AronASzucs/Avalanche32/Images/3D/iso_back_left.png

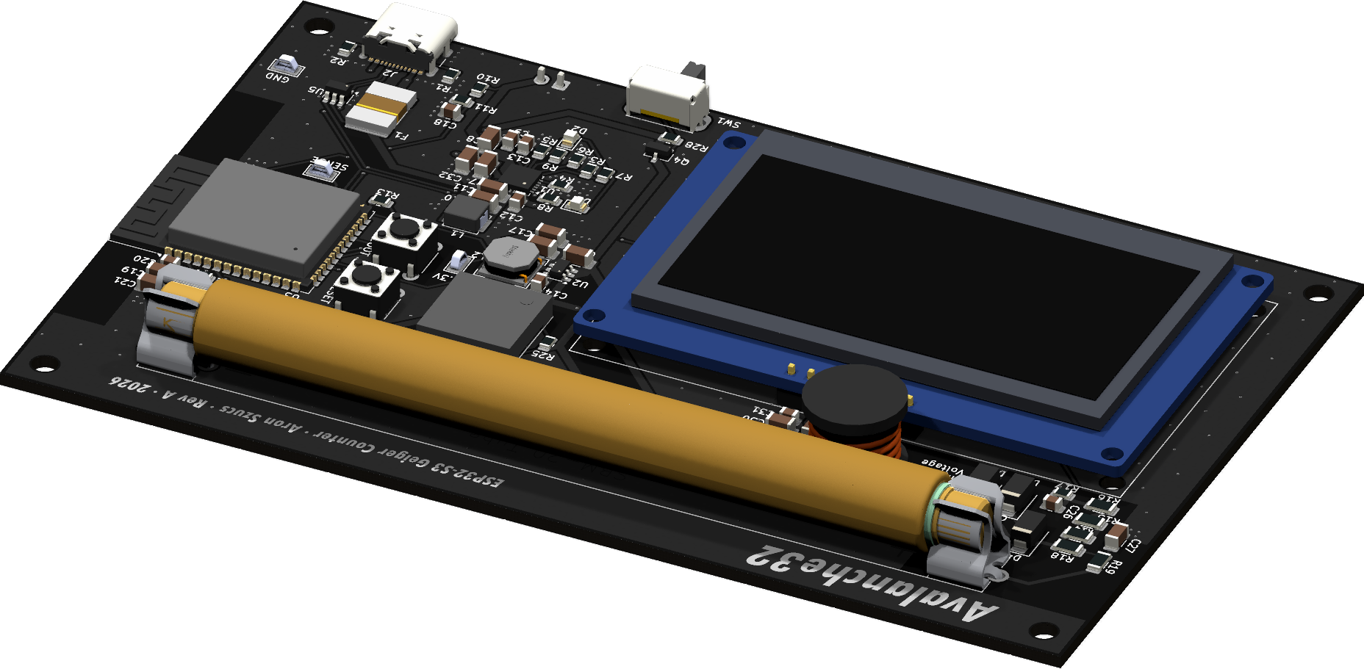
Images/3D/iso_back_left.png
