AronASzucs/Avalanche32/Images/3D/iso_back_right.png

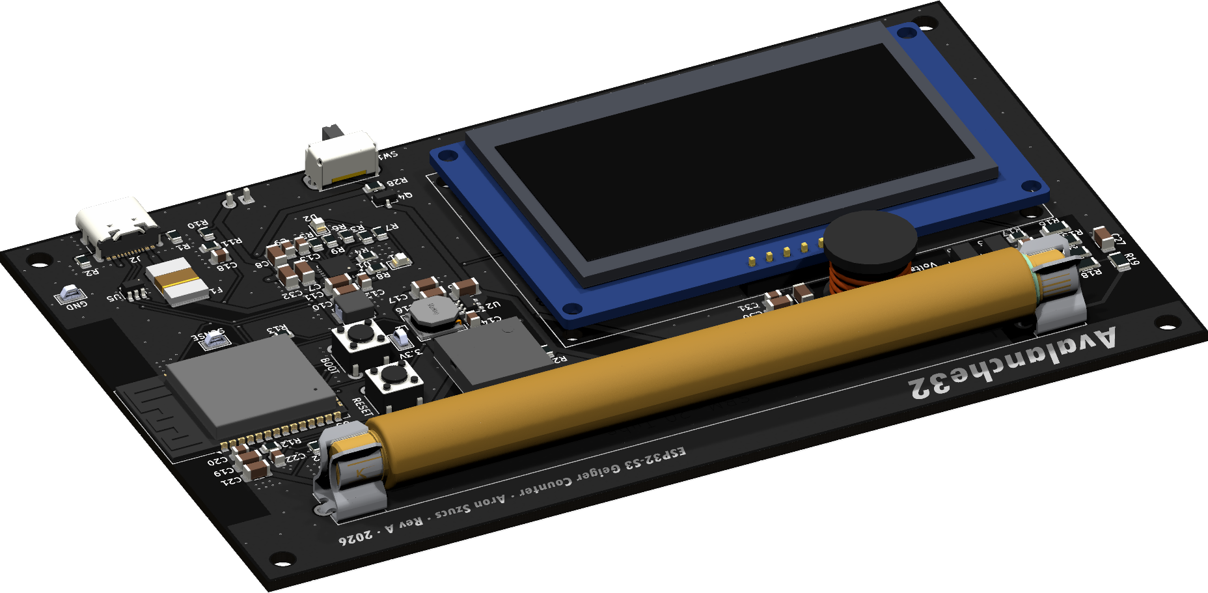
Images/3D/iso_back_right.png
