AronASzucs/Avalanche32/Images/3D/iso_bottom_back.png

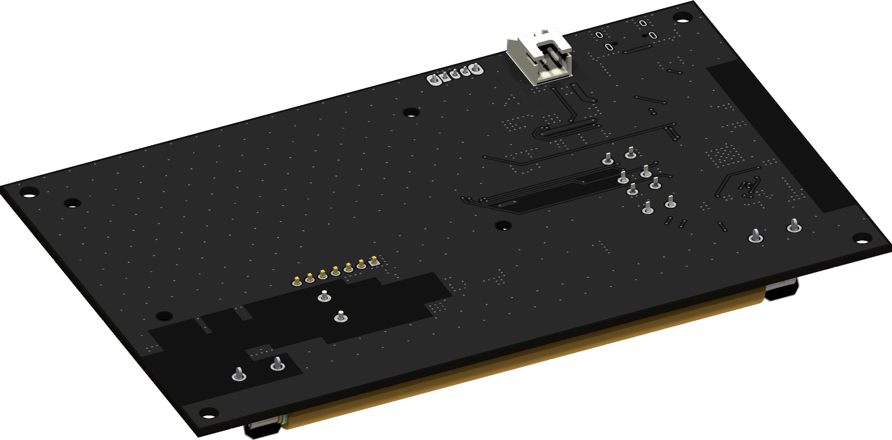
Images/3D/iso_bottom_back.png
