AronASzucs/Avalanche32/Images/3D/iso_bottom_front.png

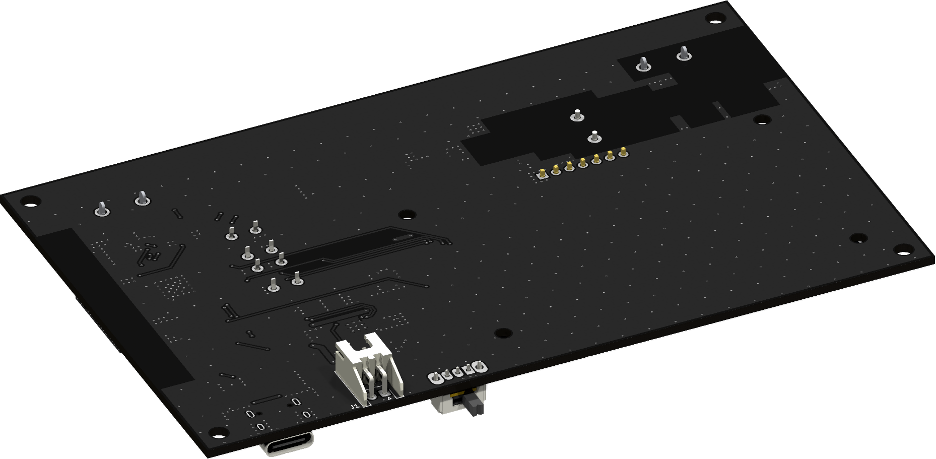
Images/3D/iso_bottom_front.png
