AronASzucs/Avalanche32/Images/3D/iso_front_right.png

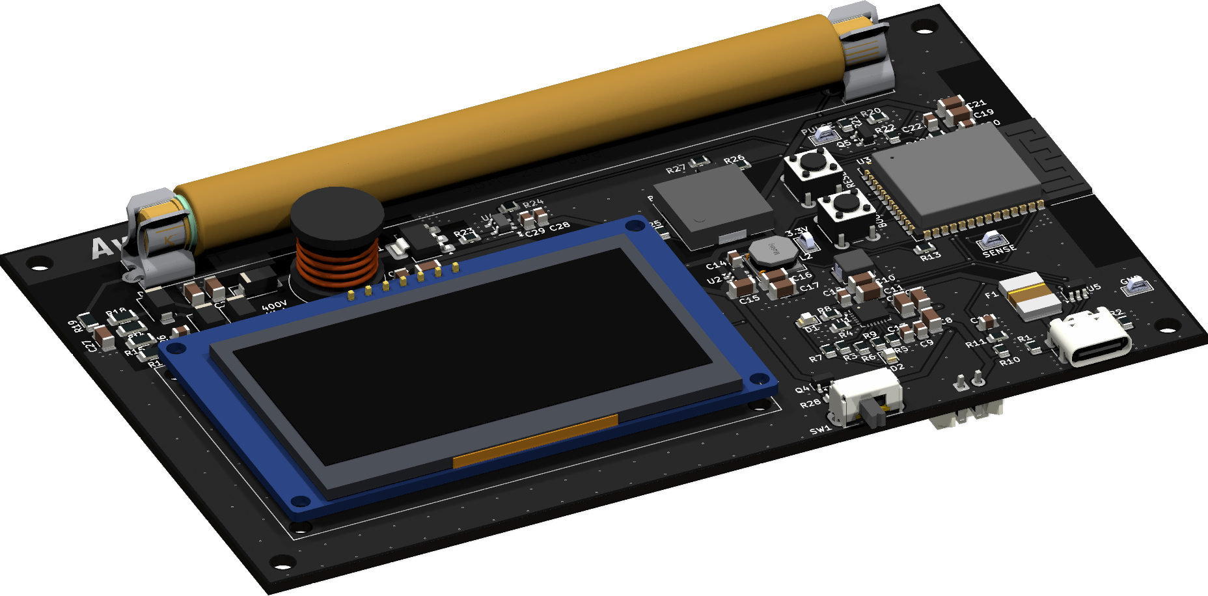
Images/3D/iso_front_right.png
