AronASzucs/Avalanche32/Images/3D/side_back.png

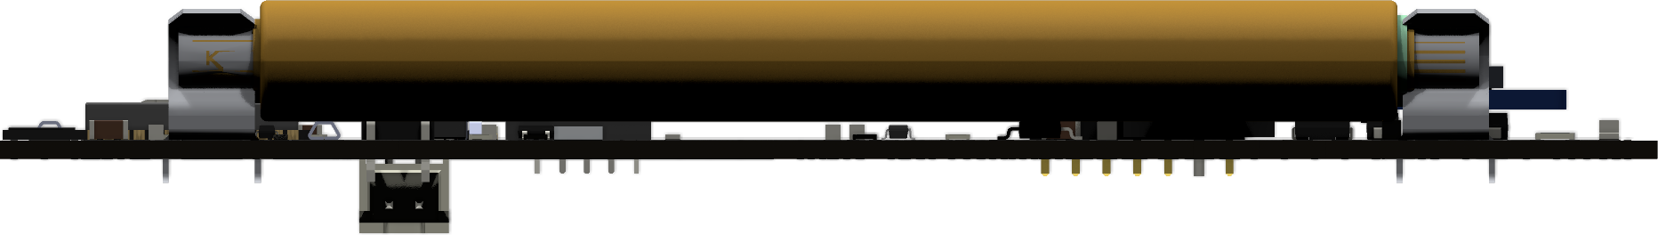
Images/3D/side_back.png
