AronASzucs/Avalanche32/Images/3D/side_front.png

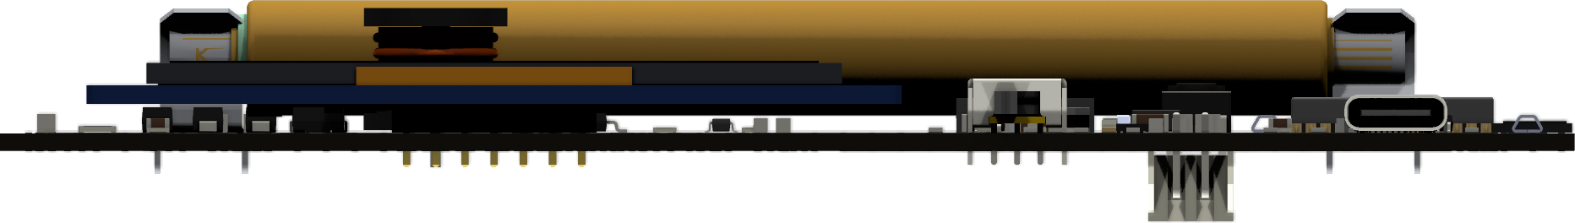
Images/3D/side_front.png
