AronASzucs/Avalanche32/Images/3D/side_left.png

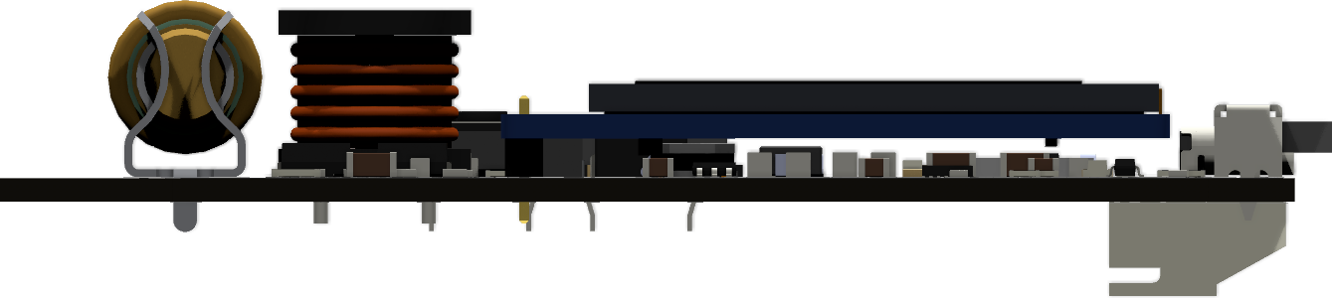
Images/3D/side_left.png
