AronASzucs/Avalanche32/Images/3D/side_right.png

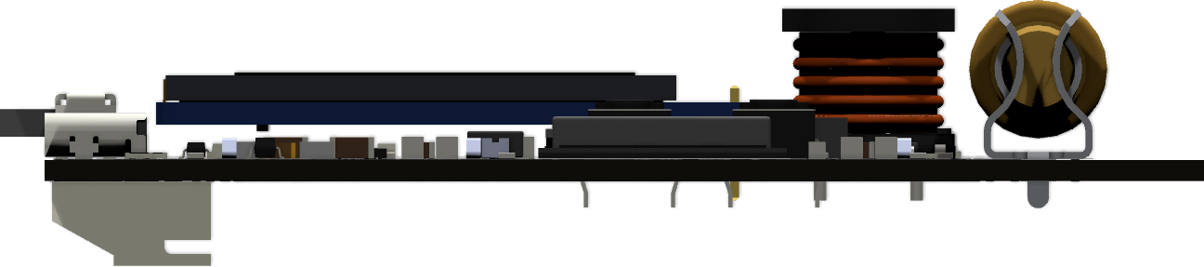
Images/3D/side_right.png
