AronASzucs/Avalanche32/Images/Layers/B_Courtyard.png

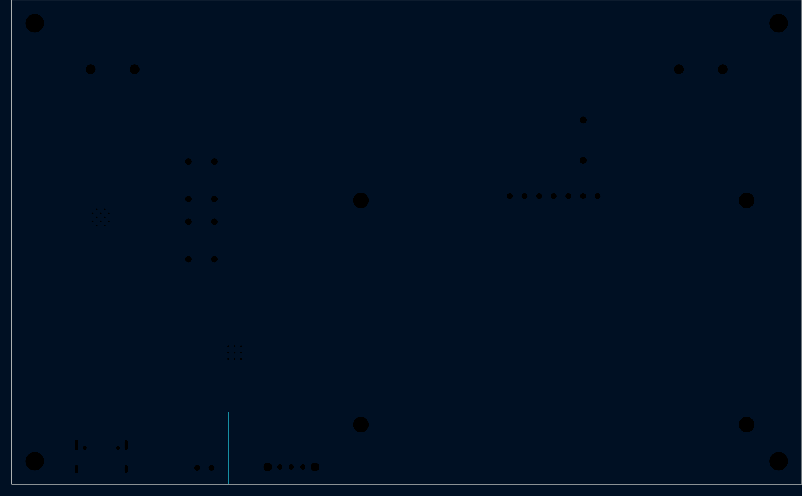
Images/Layers/B_Courtyard.png
