AronASzucs/Avalanche32/Images/Layers/B_Cu.png

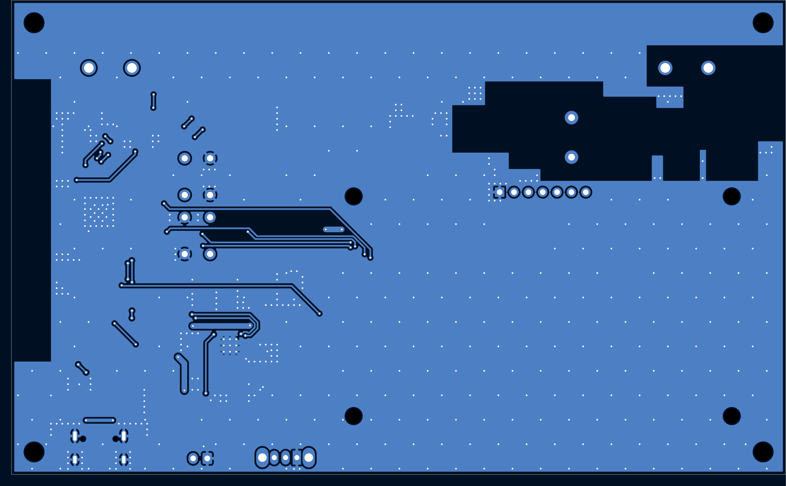
Images/Layers/B_Cu.png
