AronASzucs/Avalanche32/Images/Layers/B_Fab.png

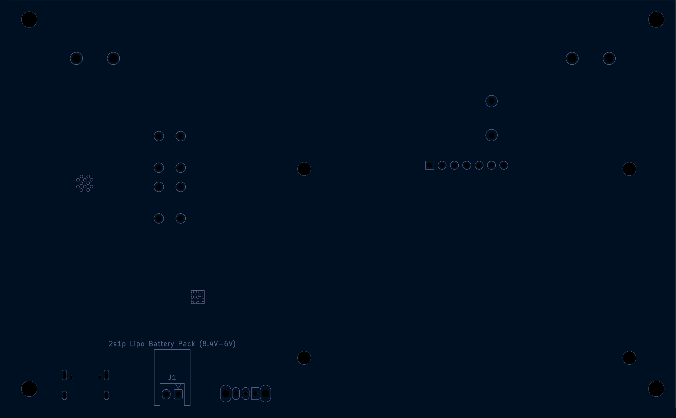
Images/Layers/B_Fab.png
