AronASzucs/Avalanche32/Images/Layers/B_Mask.png

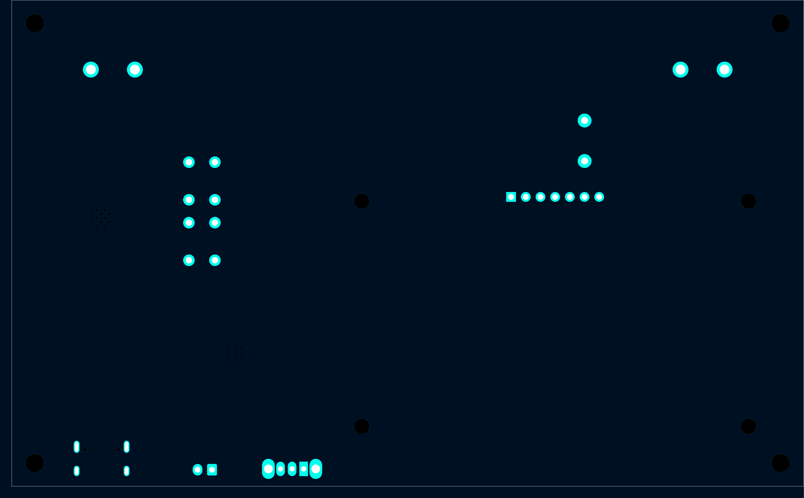
Images/Layers/B_Mask.png
