AronASzucs/Avalanche32/Images/Layers/copper_both.png

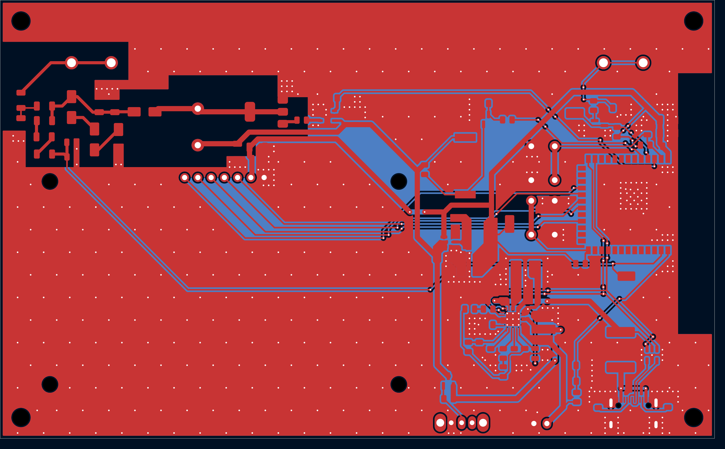
Images/Layers/copper_both.png
