AronASzucs/Avalanche32/Images/Layers/drill_map.png

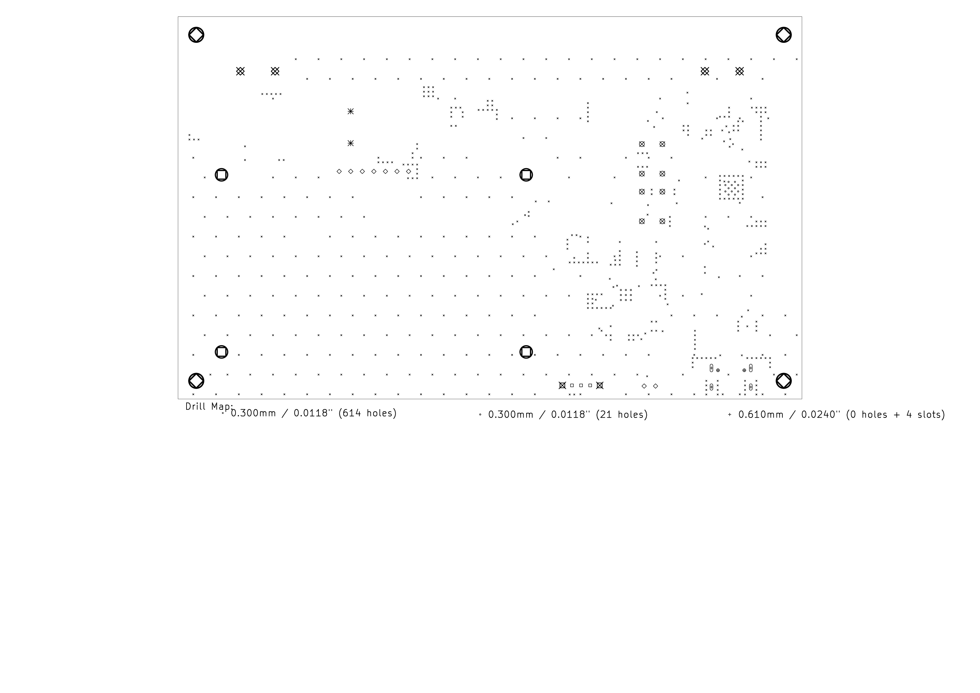
Images/Layers/drill_map.png
