AronASzucs/Avalanche32/Images/Layers/Edge_Cuts.png

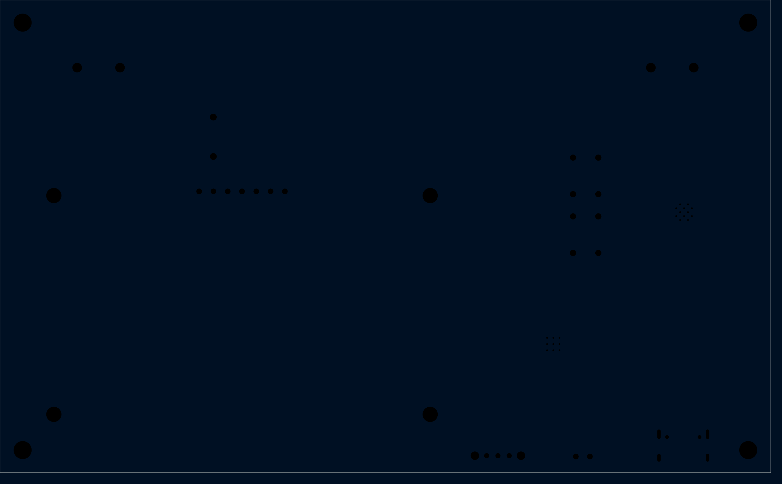
Images/Layers/Edge_Cuts.png
