AronASzucs/Avalanche32/Images/Layers/F_Courtyard.png

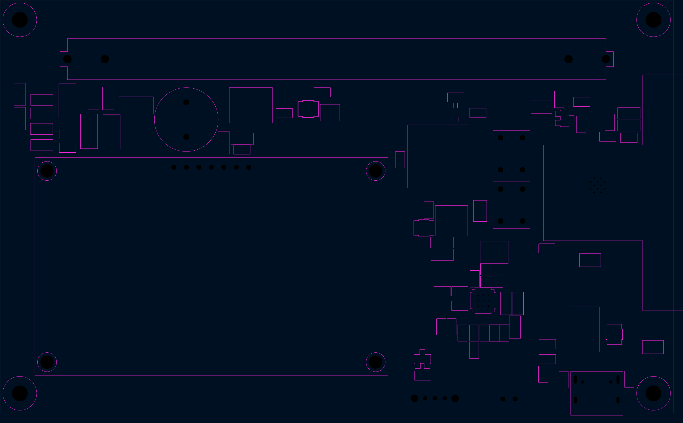
Images/Layers/F_Courtyard.png
