AronASzucs/Avalanche32/Images/Layers/F_Cu.png

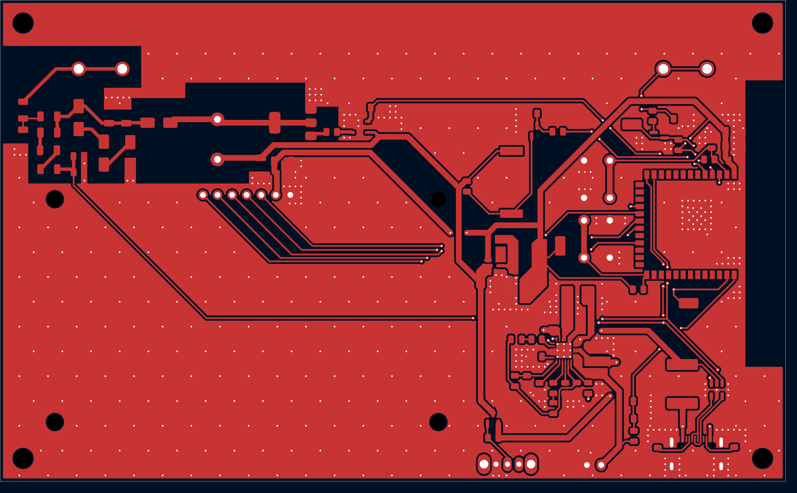
Images/Layers/F_Cu.png
