AronASzucs/Avalanche32/Images/Layers/F_Fab.png

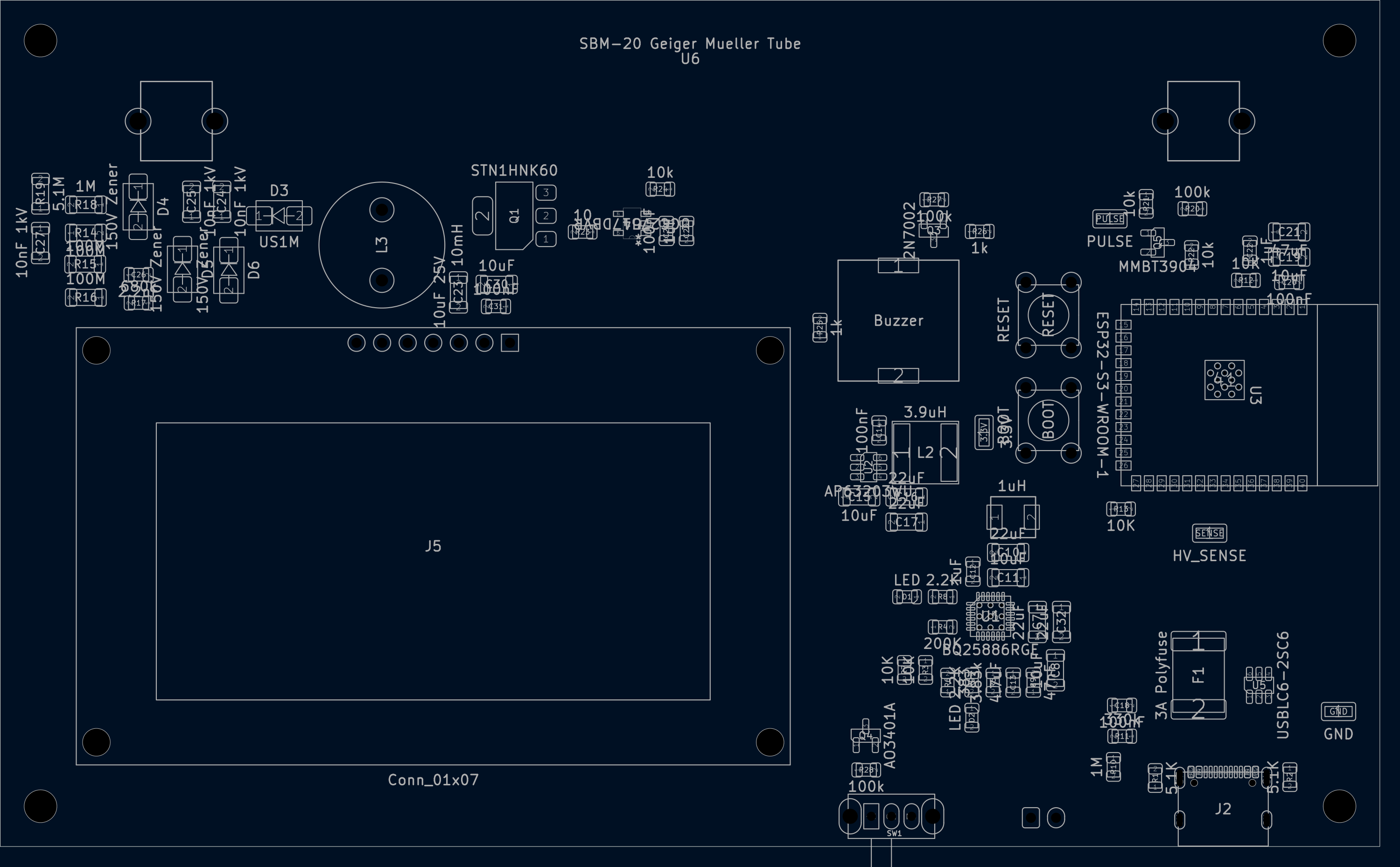
Images/Layers/F_Fab.png
