AronASzucs/Avalanche32/Images/Layers/F_Mask.png

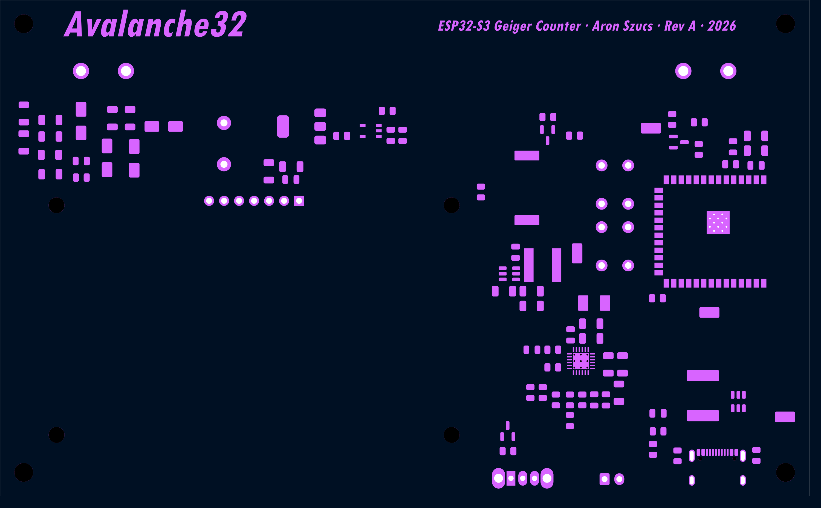
Images/Layers/F_Mask.png
