AronASzucs/Avalanche32/Images/Layers/F_Paste.png

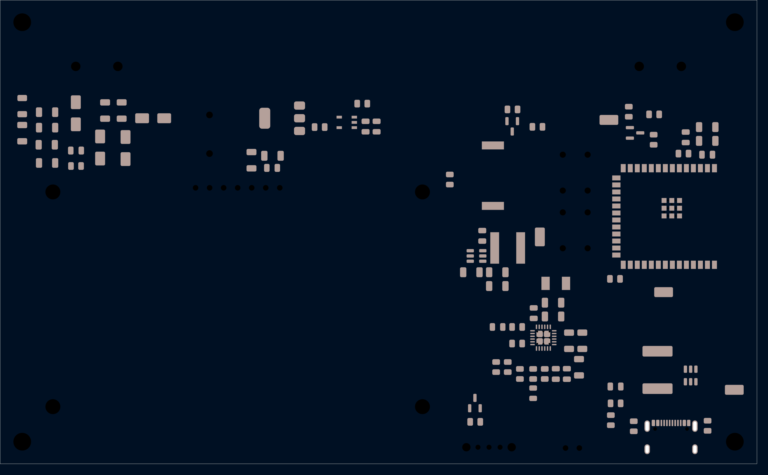
Images/Layers/F_Paste.png
