AronASzucs/Avalanche32/Images/Layers/F_Silkscreen.png

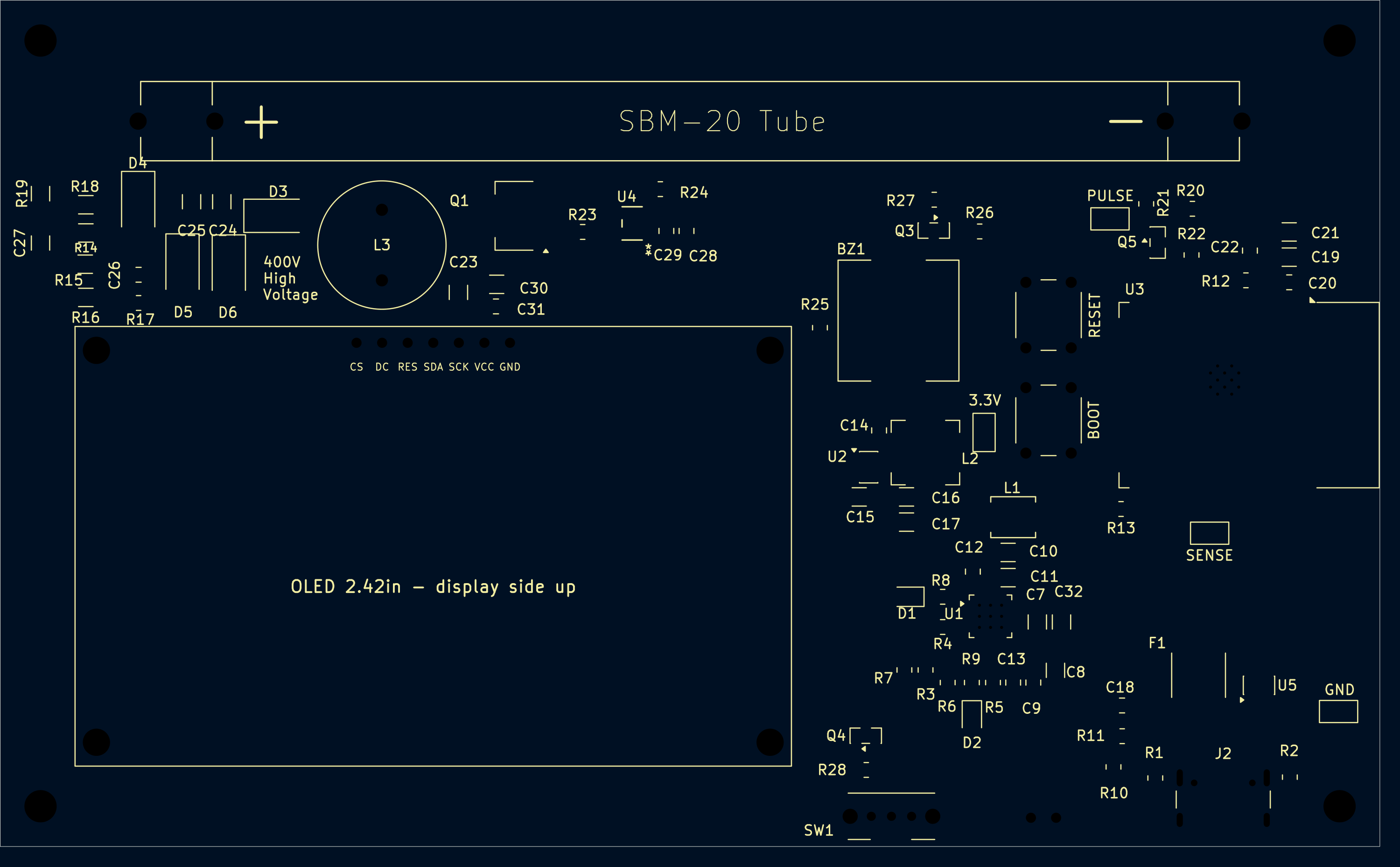
Images/Layers/F_Silkscreen.png
