AronASzucs/Avalanche32/production/bom.csv

Designator | Footprint | Quantity | Value | LCSC Part #
3.3V | TestPoint_Keystone_5015_Micro_Mini | 1 | 3.3V
BOOT | SW_PUSH_6mm | 1 | BOOT
BZ1 | XDCR_CPT-1203-78-SMT-TR | 1 | Buzzer
C10, C16, C17, C32, C7 | 1206 | 5 | 22uF
C11, C15, C19, C30, C8 | 1206 | 5 | 10uF
C12, C22, C28 | 0805 | 3 | 1uF
C13 | 0805 | 1 | 4.7uF
C14, C18, C20, C29, C31 | 0805 | 5 | 100nF
C21 | 1206 | 1 | 47uF
C23 | 1206 | 1 | 10uF 25V
C24, C25, C27 | 1206 | 3 | 10nF 1kV
C26 | 0805 | 1 | 2.2nF
C9 | 0805 | 1 | 47nF
D1, D2 | 0805 | 2 | LED
D3 | D_SMA | 1 | US1M
D4, D5, D6 | D_SMA | 3 | 150V Zener
F1 | 2920 | 1 | 3A Polyfuse
GND | TestPoint_Keystone_5015_Micro_Mini | 1 | GND
J1 | JST_XH_S2B-XH-A_1x02_P2.50mm_Horizontal | 1 | 2s1p Lipo Battery Pack (8.4V-6V)
J2 | USB_C_Receptacle_GCT_USB4105-xx-A_16P_TopMnt_Horizontal | 1 | USB_C_Receptacle_USB2.0_16P
J5 | OLED_2.42in_SSD1309_SPI_7pin | 1 | Conn_01x07
L1 | IND_SRP4020TA-1R0M | 1 | 1uH
L2 | L_Bourns-SRN6028 | 1 | 3.9uH
L3 | L_Radial_D12.5mm_P7.00mm_Fastron_09HCP | 1 | 10mH
PULSE | TestPoint_Keystone_5015_Micro_Mini | 1 | PULSE
Q1 | SOT-223-3_TabPin2 | 1 | STN1HNK60
Q3 | SOT-23 | 1 | 2N7002
Q4 | SOT-23 | 1 | AO3401A
Q5 | SOT-23 | 1 | MMBT3904
R1, R2 | 0805 | 2 | 5.1K
R10 | 0805 | 1 | 1M
R11 | 0805 | 1 | 330k
R12, R13, R21, R22, R24, R3, R7 | 0805 | 7 | 10K
R14, R15, R16 | 1206 | 3 | 100M
R17 | 0805 | 1 | 680k
R18 | 1206 | 1 | 1M
R19 | 1206 | 1 | 5.1M
R20, R27, R28 | 0805 | 3 | 100k
R23 | 0805 | 1 | 10
R25, R26 | 0805 | 2 | 1k
R4 | 0805 | 1 | 200K
R5 | 0805 | 1 | 3.83k
R6 | 0805 | 1 | 383
R8, R9 | 0805 | 2 | 2.2K
RESET | SW_PUSH_6mm | 1 | RESET
SENSE | TestPoint_Keystone_5015_Micro_Mini | 1 | HV_SENSE
SW1 | SW_Slide_SPDT_Angled_CK_OS102011MA1Q | 1 | SW_SPDT
U1 | Texas_RGE0024H_VQFN-24-1EP_4x4mm_P0.5mm_EP2.7x2.7mm_ThermalVias | 1 | BQ25886RGE
U2 | TSOT-23-6 | 1 | AP63203WU
U3 | ESP32-S3-WROOM-1 | 1 | ESP32-S3-WROOM-1
U4 | DBV5_TEX | 1 | UCC27517DBVR
U5 | SOT-23-6 | 1 | USBLC6-2SC6
U6 | SBM-20 Tube | 1 | SBM-20 Geiger Mueller Tube
