AronASzucs/Avalanche32/ESP32-Geiger-Counter.kicad_pcb

## KiCad design ESP32-Geiger-Counter.kicad_pcb (2026-10-28)

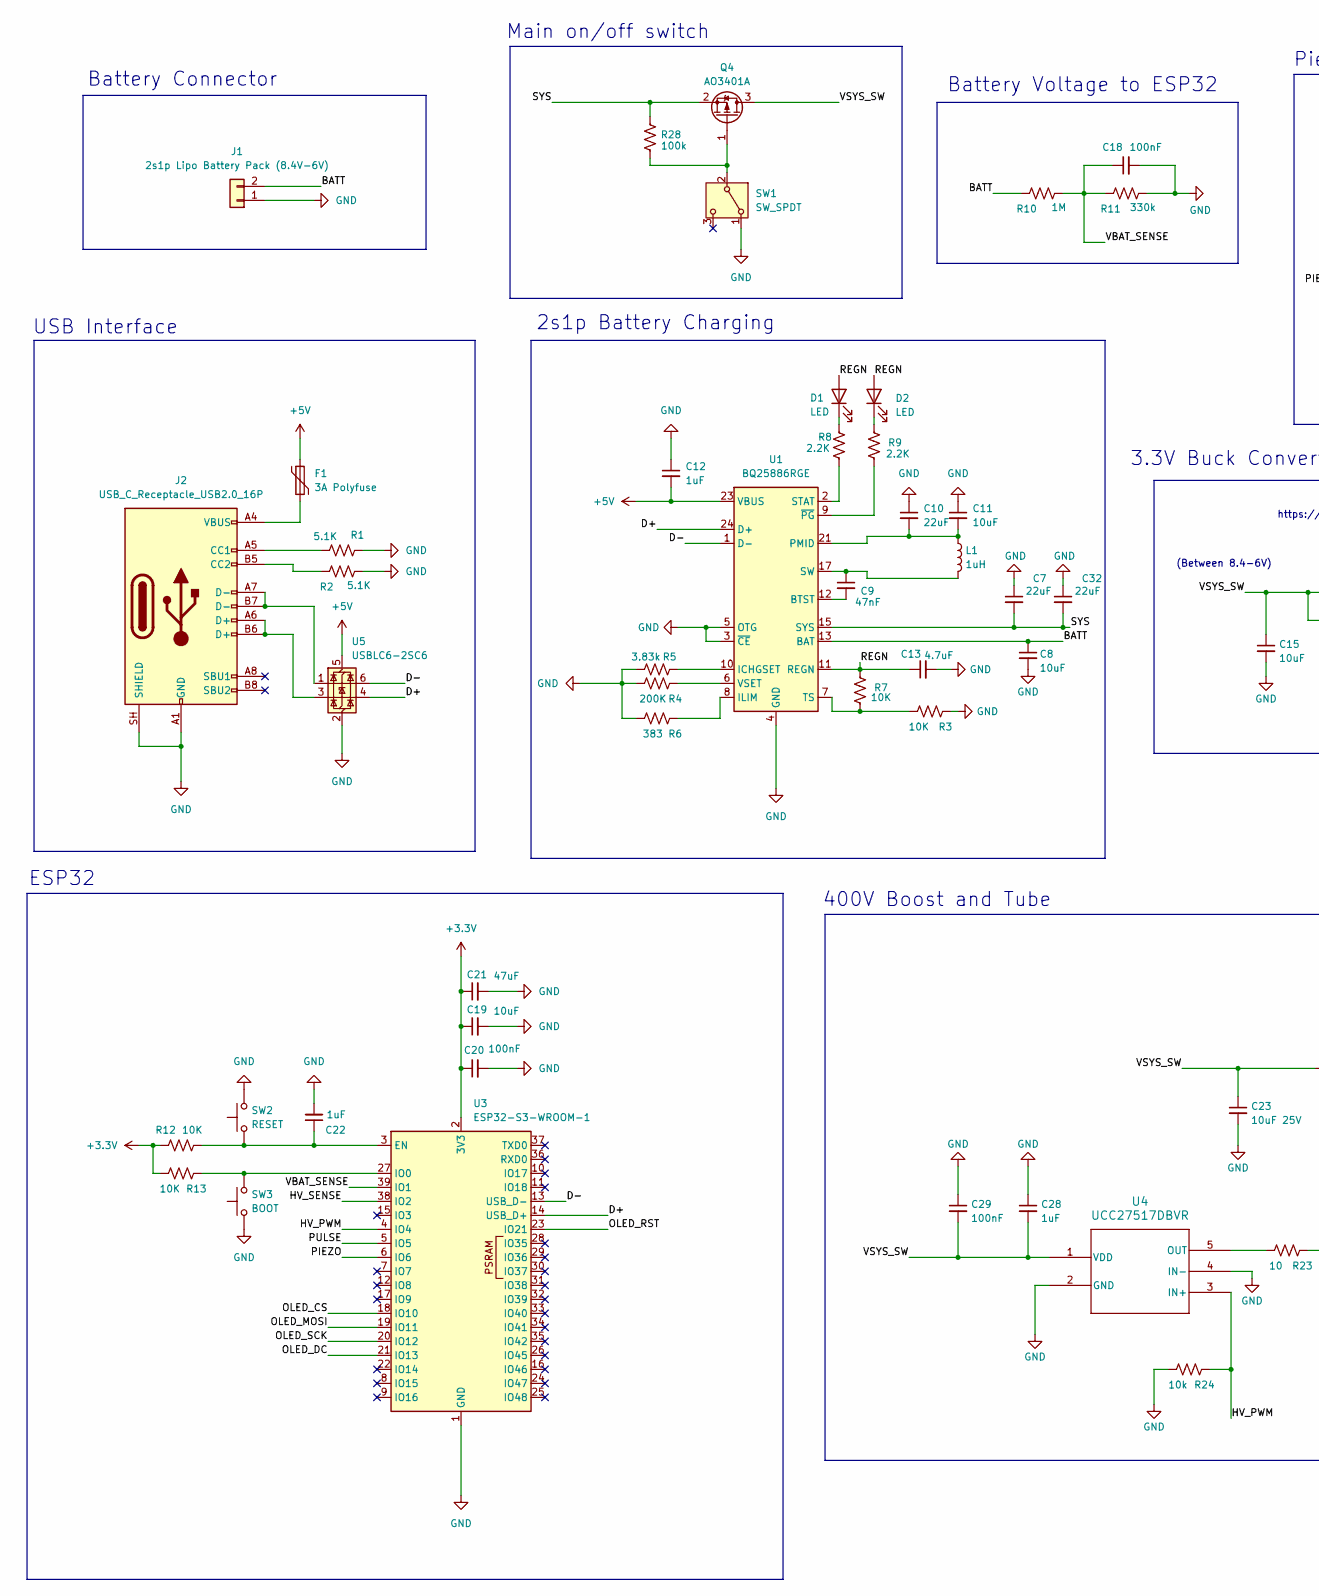
[picture p26: schematic ESP32-Geiger-Counter.kicad_sch, ESP32-based Geiger Counter, part in row 1, column 1]

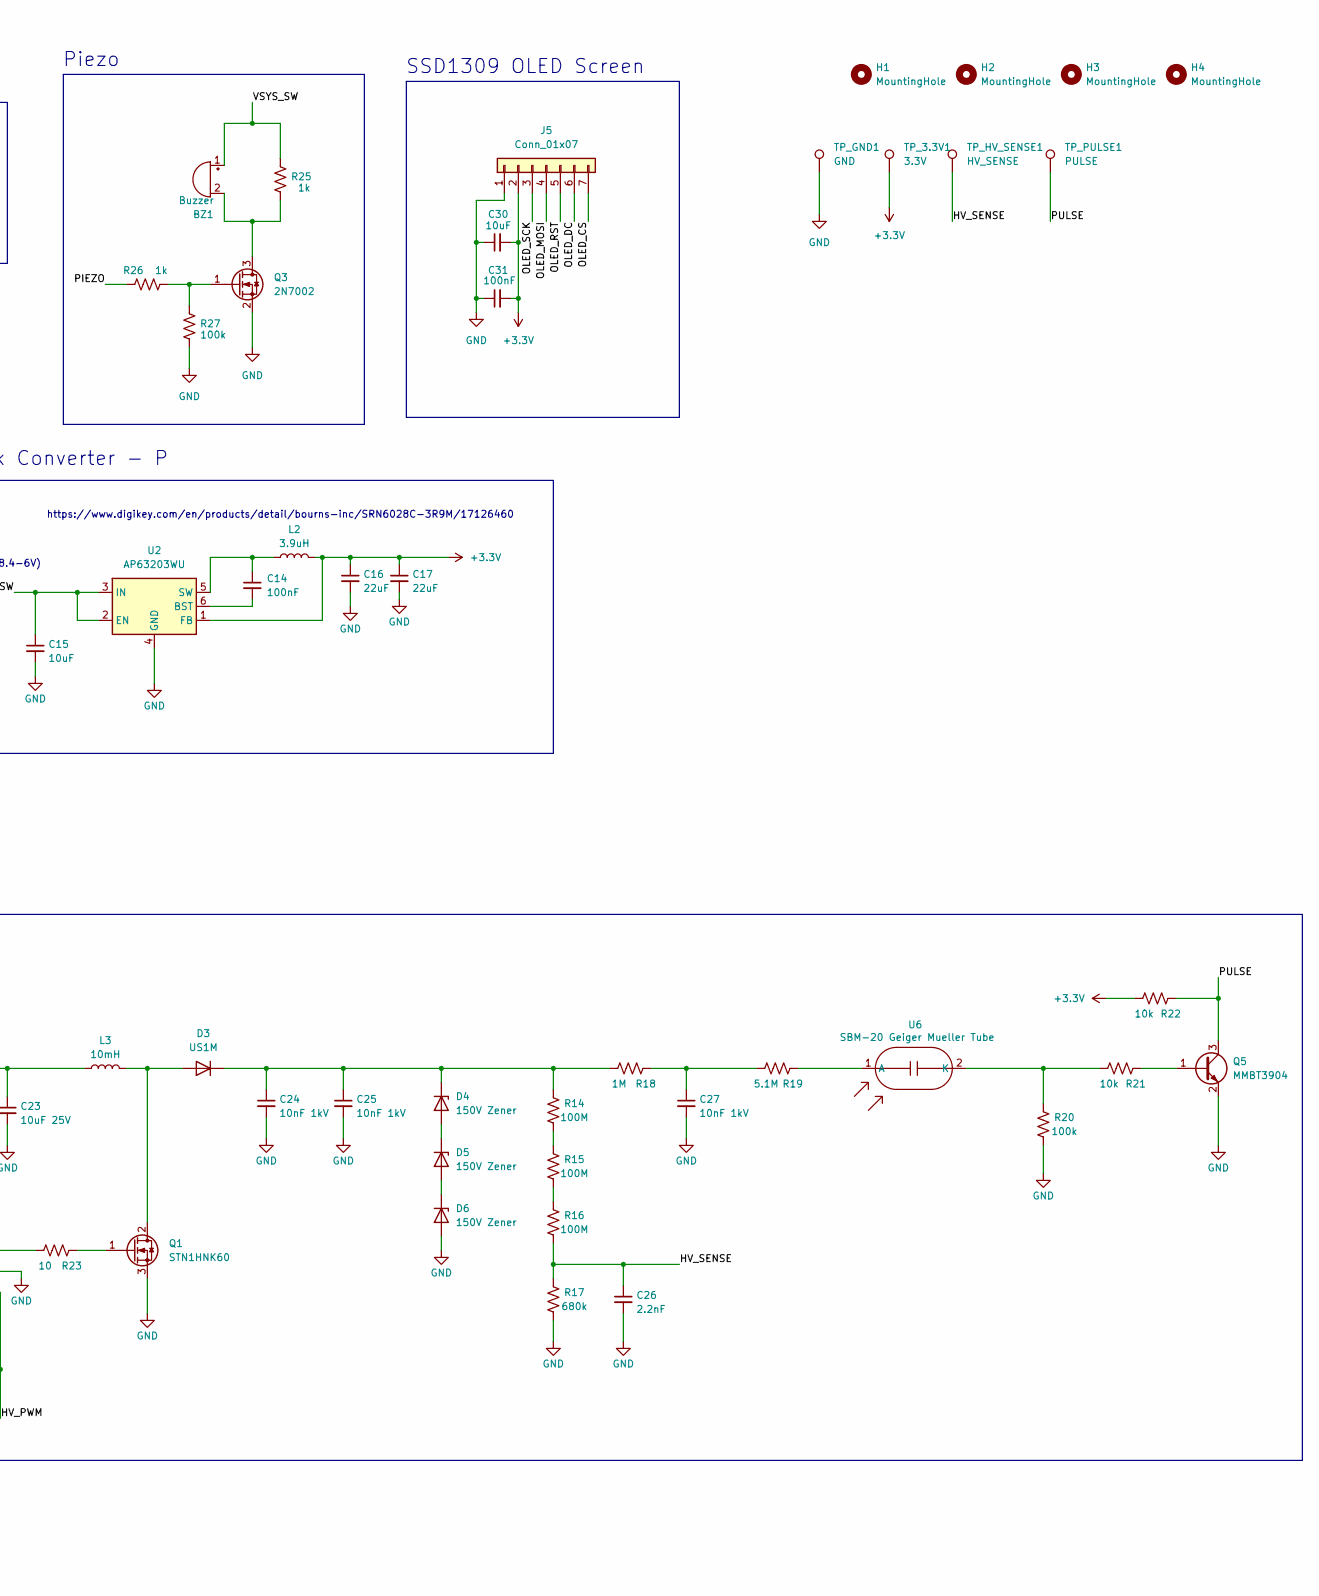
[picture p27: schematic ESP32-Geiger-Counter.kicad_sch, ESP32-based Geiger Counter, part in row 1, column 2]

Parts:
BZ1: Buzzer; XDCR_CPT-1203-78-SMT-TR
C7, C10, C16, C17, C32: 22uF; C_1206_3216Metric
C8, C11, C15, C19, C30: 10uF; C_1206_3216Metric
C9: 47nF; C_0805_2012Metric
C12, C22, C28: 1uF; C_0805_2012Metric
C13: 4.7uF; C_0805_2012Metric
C14, C18, C20, C29, C31: 100nF; C_0805_2012Metric
C21: 47uF; C_1206_3216Metric
C23: 10uF 25V; C_1206_3216Metric
C24, C25, C27: 10nF 1kV; C_1206_3216Metric
C26: 2.2nF; C_0805_2012Metric
D1, D2: LED; LED_0805_2012Metric
D3: US1M; D_SMA
D4, D5, D6: 150V Zener; D_SMA
F1: 3A Polyfuse; Fuse_2920_7451Metric
H1, H2, H3, H4: MountingHole; MountingHole_3.2mm_M3
J1: 2s1p Lipo Battery Pack (8.4V-6V); JST_XH_S2B-XH-A_1x02_P2.50mm_Horizontal
J2: USB_C_Receptacle_USB2.0_16P; USB_C_Receptacle_GCT_USB4105-xx-A_16P_TopMnt_Horizontal
J5: Conn_01x07; OLED_2.42in_SSD1309_SPI_7pin
L1: 1uH; IND_SRP4020TA-1R0M
L2: 3.9uH; L_Bourns-SRN6028
L3: 10mH; L_Radial_D12.5mm_P7.00mm_Fastron_09HCP
Q1: STN1HNK60; SOT-223-3_TabPin2
Q3: 2N7002; SOT-23
Q4: AO3401A; SOT-23
Q5: MMBT3904; SOT-23
R1, R2: 5.1K; R_0805_2012Metric
R3, R7, R12, R13: 10K; R_0805_2012Metric
R4: 200K; R_0805_2012Metric
R5: 3.83k; R_0805_2012Metric
R6: 383; R_0805_2012Metric
R8, R9: 2.2K; R_0805_2012Metric
R10: 1M; R_0805_2012Metric
R11: 330k; R_0805_2012Metric
R14, R15, R16: 100M; R_1206_3216Metric
R17: 680k; R_0805_2012Metric
R18: 1M; R_1206_3216Metric
R19: 5.1M; R_1206_3216Metric
R20, R27, R28: 100k; R_0805_2012Metric
R21, R22, R24: 10k; R_0805_2012Metric
R23: 10; R_0805_2012Metric
R25, R26: 1k; R_0805_2012Metric
SW1: SW_SPDT; SW_Slide_SPDT_Angled_CK_OS102011MA1Q
SW2: RESET; SW_PUSH_6mm
SW3: BOOT; SW_PUSH_6mm
TP_3.3V1: 3.3V; TestPoint_Keystone_5015_Micro_Mini
TP_GND1: GND; TestPoint_Keystone_5015_Micro_Mini
TP_HV_SENSE1: HV_SENSE; TestPoint_Keystone_5015_Micro_Mini
TP_PULSE1: PULSE; TestPoint_Keystone_5015_Micro_Mini
U1: BQ25886RGE; Texas_RGE0024H_VQFN-24-1EP_4x4mm_P0.5mm_EP2.7x2.7mm_Thermal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
U2: AP63203WU; TSOT-23-6
U3: ESP32-S3-WROOM-1
U4: UCC27517DBVR; DBV5_TEX
U5: USBLC6-2SC6; SOT-23-6
U6: SBM-20 Geiger Mueller Tube; SBM-20 Tube

Connections:
+3.3V: C16.1, C17.1, C19.1, C20.1, C21.1, C30.2, C31.2, J5.2, L2.2, R12.2, R13.1, R22.1, TP_3.3V1.1, U2.1 (FB), U3.2 (3V3); also elsewhere on the board
+5V: C12.2, F1.1, U1.23 (VBUS), U5.5 (VBUS)
/BATT: C8.1, J1.2, R10.2, U1.13 (BAT), U1.14 (BAT)
/D+: U1.24 (D+), U3.14 (USB_D+), U5.4 (I/O2)
/D-: U1.1 (D-), U3.13 (USB_D-), U5.6 (I/O1)
/HV_PWM: R24.2, U3.4 (IO4), U4.3 (IN+)
/HV_SENSE: C26.1, R16.1, R17.2, TP_HV_SENSE1.1, U3.38 (IO2); also elsewhere on the board
/OLED_CS: J5.7, U3.18 (IO10)
/OLED_DC: J5.6, U3.21 (IO13)
/OLED_MOSI: J5.4, U3.19 (IO11)
/OLED_RST: J5.5, U3.23 (IO21)
/OLED_SCK: J5.3, U3.20 (IO12)
/PIEZO: R26.2, U3.6 (IO6)
/PULSE: Q5.3 (C), R22.2, TP_PULSE1.1, U3.5 (IO5); also elsewhere on the board
/REGN: C13.1, D1.2 (A), D2.2 (A), R7.2, U1.11 (REGN)
/SYS: C7.2, C32.2, Q4.2 (S), R28.2, U1.15 (SYS), U1.16 (SYS)
/VBAT_SENSE: C18.1, R10.1, R11.2, U3.39 (IO1)
/VSYS_SW: BZ1.1 (+), C15.1, C23.1, C28.2, C29.2, L3.1, Q4.3 (D), R25.2, U2.2 (EN), U2.3 (IN), U4.1 (VDD)
GND: C7.1, C8.2, C10.1, C11.1, C12.1, C13.2, C15.2, C16.2, C17.2, C18.2, C19.2, C20.2, C21.2, C22.2, C23.2, C24.2, C25.2, C26.2, C27.2, C28.1, C29.1, C30.1, C31.1, C32.1, D6.2 (A), J1.1, J2.A1 (GND), J2.A12 (GND), J2.B1 (GND), J2.B12 (GND), J2.SH (SHIELD), J5.1, Q1.3 (S), Q3.2 (S), Q5.2 (E), R1.2, R2.1, R3.2, R4.1, R5.2, R6.1, R11.1, R17.1, R20.1, R24.1, R27.1, SW1.1 (A), SW2.2, SW3.1, TP_GND1.1, U1.3 (~CE), U1.4 (GND), U1.5 (OTG), U1.19 (GND), U1.20 (GND), U1.25 (GND), U2.4 (GND), U3.1 (GND), U3.40 (GND), U3.41 (GND), U4.2 (GND), U4.4 (IN-), U5.2 (GND); also elsewhere on the board
unnamed: BZ1.2 (-), Q3.3 (D), R25.1
unnamed: C9.1, L1.2, U1.17 (SW), U1.18 (SW)
unnamed: C10.2, C11.2, L1.1, U1.21 (PMID), U1.22 (PMID)
unnamed: C27.1, R18.2, R19.1
unnamed: D1.1 (K), R8.2
unnamed: D2.1 (K), R9.2
unnamed: D3.2 (A), L3.2, Q1.2 (D)
unnamed: C24.1, C25.1, D3.1 (K), D4.1 (K), R14.2, R18.1
unnamed: D4.2 (A), D5.1 (K)
unnamed: D5.2 (A), D6.1 (K)
unnamed: F1.2, J2.A4 (VBUS), J2.A9 (VBUS), J2.B4 (VBUS), J2.B9 (VBUS)
unnamed: J2.A5 (CC1), R1.1
unnamed: J2.B5 (CC2), R2.2
unnamed: J2.A6 (D+), J2.B6 (D+), U5.3 (I/O2)
unnamed: J2.A7 (D-), J2.B7 (D-), U5.1 (I/O1)
unnamed: Q1.1 (G), R23.2
unnamed: Q3.1 (G), R26.1, R27.2
unnamed: Q4.1 (G), R28.1, SW1.2 (B)
unnamed: Q5.1 (B), R21.2
unnamed: R14.1, R15.2
unnamed: R15.1, R16.2
unnamed: C9.2, U1.12 (BTST)
unnamed: R5.1, U1.10 (ICHGSET)
unnamed: R6.2, U1.8 (ILIM)
unnamed: R8.1, U1.2 (STAT)
unnamed: R3.1, R7.1, U1.7 (TS)
unnamed: R4.2, U1.6 (VSET)
unnamed: R9.1, U1.9 (~PG)
unnamed: C14.2, U2.6 (BST)
unnamed: C14.1, L2.1, U2.5 (SW)
unnamed 49: C22.1, R12.1, SW2.1, U3.3 (EN); also elsewhere on the board
unnamed 50: R13.2, SW3.2, U3.27 (IO0); also elsewhere on the board
unnamed: R23.1, U4.5 (OUT)
unnamed: R19.2, U6.1 (A)
unnamed: R20.2, R21.1, U6.2 (K)

Notes on the sheet:
2s1p Battery Charging
ESP32
Main on/off switch
Battery Voltage to ESP32
USB Interface
(Between 8.4-6V)
Piezo
https://www.digikey.com/en/products/detail/bourns-inc/SRN6028C-3R9M/17126460
Battery Connector
SSD1309 OLED Screen
400V Boost and Tube
3.3V Buck Converter - P

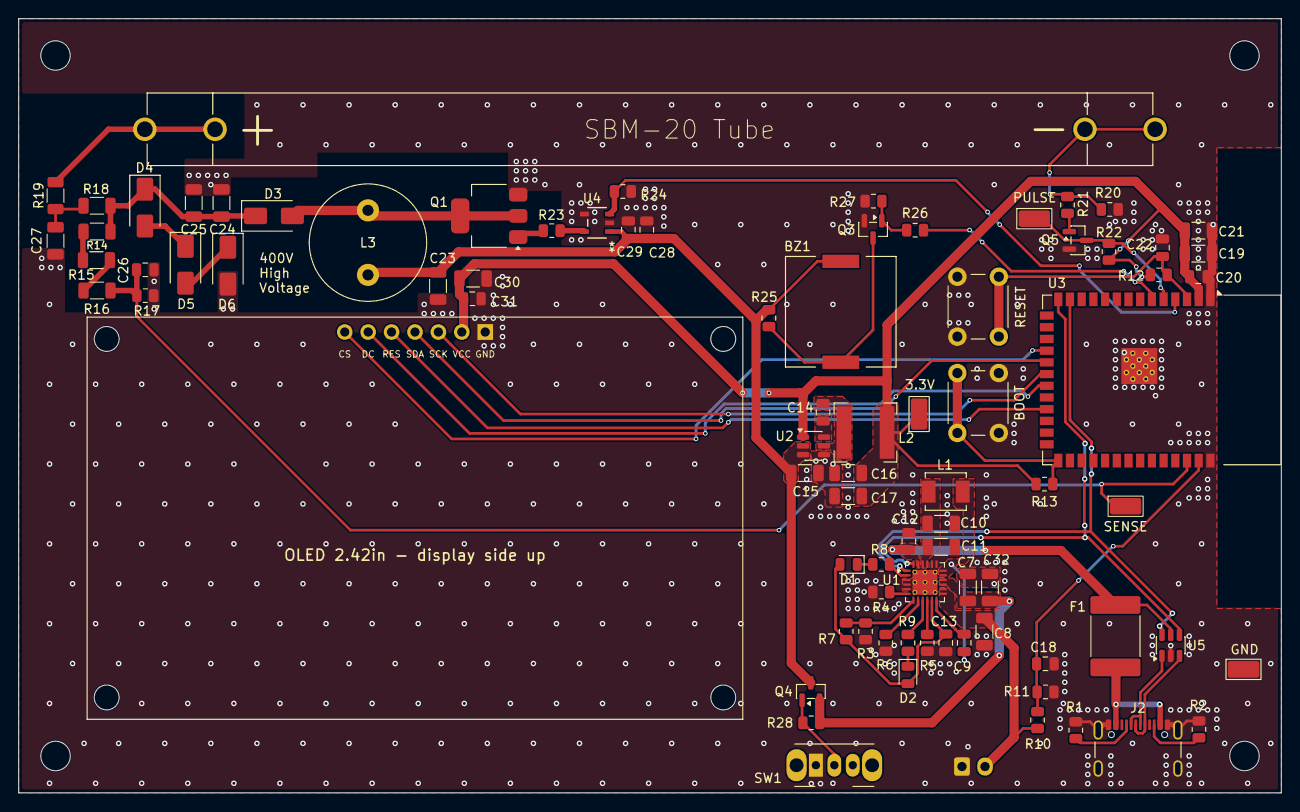
[picture p28: board ESP32-Geiger-Counter.kicad_pcb from above]

Board: 2 copper layers, 137.0 x 84.0 mm, 89 parts (1 on the bottom side), 54 nets.

Other parts of the board:
3.3V: 3.3V; TestPoint_Keystone_5015_Micro_Mini
BOOT: BOOT; SW_PUSH_6mm
GND: GND; TestPoint_Keystone_5015_Micro_Mini
PULSE: PULSE; TestPoint_Keystone_5015_Micro_Mini
RESET: RESET; SW_PUSH_6mm
SENSE: HV_SENSE; TestPoint_Keystone_5015_Micro_Mini

Their connections:
+3.3V: 3.3V.1 (1_1); also elsewhere on the board
/HV_SENSE: SENSE.1 (1_1); also elsewhere on the board
/PULSE: PULSE.1 (1_1); also elsewhere on the board
GND: BOOT.1, GND.1 (1_1), RESET.2; also elsewhere on the board
unnamed 49: RESET.1; also elsewhere on the board
unnamed 50: BOOT.2; also elsewhere on the board
