AronASzucs/Avalanche32/(commit log)

2026-10-11 added tvs diode protection for usb c
2026-10-11 added a bunch of passive footprints
2026-10-11 added more passive footprints
2026-10-11 Revise README with project updates and known issues
    Updated project status and detailed specifications for components, including HV supply and detection methods. Added known issue with the SBM-20 tube and provided firmware details.
2026-10-12 made power switch power a fet instead of switching entire current
2026-10-12 added sbm20 footprint
2026-10-14 Revise README with project status and measurement details
    Updated the README to reflect the current status and measurements of the ESP32 Geiger Counter project, including changes to the battery supply details and detection components.
2026-10-14 board layout changes
2026-10-17 added 400v boost to board
2026-10-17 some wiring
2026-10-18 top gnd pour
2026-10-25 pour changes, fixed bad sbm-20 tube footprint
2026-10-27 final board to order
2026-10-27 changed pcb color to black and also redid pics
2026-10-27 README edit
    Removed the tilde from the voltage supply description for clarity.
